EVR0/Inhaler-Counter-Project/2023 Team Final Report.docx

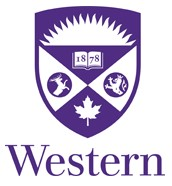
[picture p1: figure]
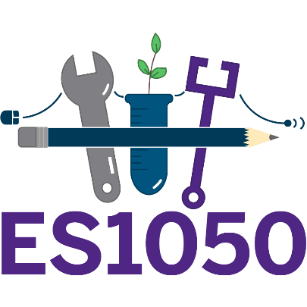
[picture p2: figure]

Western University Faculty of Engineering

Studio Section 027 – Jonathon Southen

Team Identifier: 27INHAL

Team Members: Richard Augustine, Anuda Dissanayake, Theo Graboski, Dylan Lo, Evan Romano, Ishan Randhawa

# Project Title: Non-Visual Inhaler Counter

Design Description: An electronically powered inhaler counter that utilizes audio feedback to communicate doses remaining in a canister to those who are visually impaired.

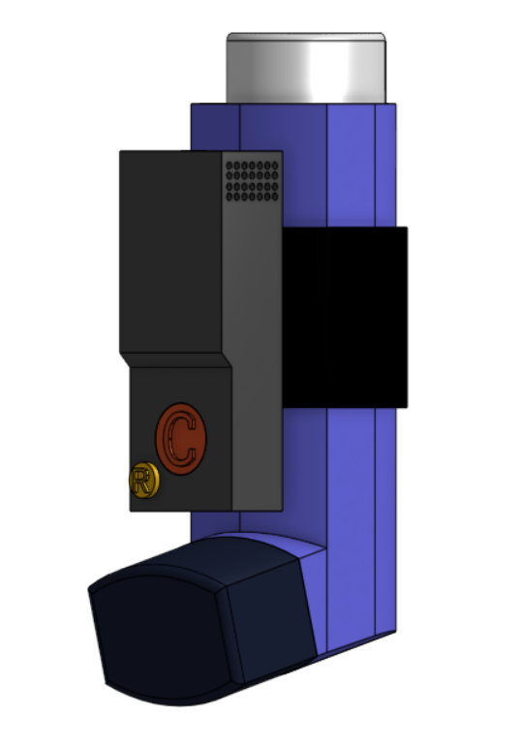
[picture p3: figure]

# 1 Need / Challenge

People with asthma and visual impairments need an easier method of monitoring the medicine consumption and availability of various inhaler types, because current methods of measurement are too visually oriented and lack tactile or auditory feedback.

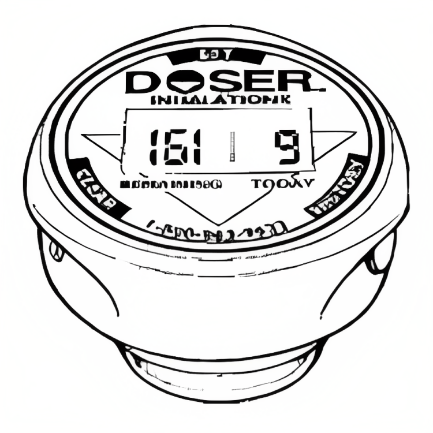
[picture p4: figure]
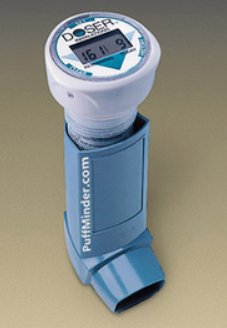
[picture p5: figure]

Existing inhaler counters in the market are solely visual-oriented, and there are none that use audio feedback to communicate remaining dosage. An example shown is the PuffMinder DOSER, which is an inhaler attachment that displays dosage using a segment display (PuffMinder). This highlights the need, from visually impaired communities, for a non-visual inhaler counter.

# 2 Final Design Documentation

REF: Figure 1: List of materials used to create the inhaler counter

Some additional tools used:

- Soldering iron
- 3D printer
- Hot glue gun
- Dremel tool

Design Overview:

Our design solution aimed to address the challenges faced by visually or audibly impaired individuals who struggle to keep track of the amount of medication left in their inhalers. Existing inhaler counters are unable to cater to the unique needs of individuals with visual or hearing impairments, making it extremely challenging for them to keep track of their medication intake.

To tackle this issue, we developed an innovative inhaler counter that incorporates both haptic and audible feedback mechanisms. The compact and easily accessible attachment comprises an Arduino circuit, a piezo buzzer, and a small 5V speaker, all of which are safely enclosed in a durable 3D-printed plastic case, connected to a small power bank, connected with a micro-USB port. The counter comes equipped with two large buttons, one to check the current dosage amount in the canister, and the other to count down the dosage. The buttons are purposely constructed larger to allow blind people to locate them easier.

Buttons:

The red button (distinguished for blind people with a little bump on top of it) serves as the counting button, and the counter will give a warning sound and buzz when the inhaler is low on puffs, indicated by counts below 20% on the counter. To reset the counter to the desired number of counts, the client simply holds down the red button for 2 seconds. The counter will automatically increase the number of doses by increments of 10 counts, making it versatile for different dosage-holding inhalers.

The yellow button is designed to read the current dosage of the inhaler. When pressed, the inhaler will play 3 jingles/buzzes if it is full or almost full-on dosage. As the inhaler reaches below 50% counts, the jingles will reduce to 2 jingles/buzzes. When the inhaler is low on counts (below 20%), the jingles will reduce to 1 jingle/buzz, signaling that the user should refill their medication. Both these buttons would sit flush with the case, modelled after how the buttons of car-keys sit flush with the case, to avoid accidental pressing of any of the buttons. The adjustable elastic band strap ensures that the inhaler counter is compatible with various types of inhalers, enabling clients to get an accurate estimate of their remaining medication. We decided against a Velcro-band due to the noise it creates when you detach and attach the band, which could potentially be irritating for the client.

3D-Printed inhaler Counter Case:

The case is constructed from a 3D printed PLA plastic, which is a cost and material effective solution to in-case the circuitry of the inhaler counter. This material is durable and lightweight to allow for easy portability. Holes were manually drilled in the front of the case to allow the speaker to be heard easier, similarly to how some children’s speaker toys have holes in the case to project the audio of the speaker. To ensure all the parts, stay in place inside the case, which used a Velcro band to essentially hold the circuit down to the base of the case.

REF: Figure 2: CAD model of the counter on an inhaler – front, side, and bird’s eye view.

3D Printed case CAD: https://cad.onshape.com/documents/8a499796033188533e099d55/w/adf7a8520d7a87b5bd451792/e/a437b7ff1ce1cee1345235dd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

CAD of the inhaler counter attached to the inhaler: https://cad.onshape.com/documents/7b21c56eded4eb05811d0dd9/w/42491a1a2af8003230763df1/e/c076f92898ddc23516b42c1d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

REF: Figure 3: Sketch/ diagram of the inhaler counter in multiple views and dimensions provided.

The electronic circuitry used in our inhaler counter consists of:

1. Buttons: To connect a button to an Arduino, connect one leg of the button to a digital input pin on the Arduino and the other leg to ground. We also added a pull-up/pull-down resistor to ensure a reliable input state.
2. Buzzer: To connect a buzzer to an Arduino, connect the positive leg of the buzzer to a digital output pin on the Arduino and the negative leg to ground. The use of the tone() function in the Arduino code is able to generate a specific frequency on the buzzer.
3. Speaker: To connect a speaker to an Arduino, we needed an amplifier circuit since the Arduino output pins can't drive a speaker directly. The amplifier chip we decided to build for this circuit is the LM386, which you can connect to the analog output pins of the Arduino. Then, we connected the speaker to the LM386 output pins.

All of which was connected on a protoboard instead of a breadboard which comes with several advantages:

A thin protoboard, also known as a low-profile protoboard, is a type of breadboard that is thinner than a standard breadboard. Thin protoboards are useful for a variety of reasons:

Space-saving: Thin protoboards take up less space than standard breadboards, which makes them ideal for small electronic projects where space is at a premium. Allow wires to connect above and below the protoboard which can save lots of extra space on the breadboard if wires are connected neatly.

Portable: Due to their compact size and light weight, thin protoboards are highly portable, making them ideal for use in the field or for mobile projects.

Easier to handle: Thin protoboards are easier to handle and manipulate than standard breadboards, which can be bulky and difficult to work with. This can be particularly useful when working with delicate or small electronic components.

Better signal integrity: Because thin protoboards have shorter and more direct connections between the components, they can provide better signal integrity, which is important for many electronic applications. This can be especially important when working with high-frequency or sensitive electronic circuits.

The main source of power which perform all the circuit functions was an Arduino Nano. The Arduino Nano is a compact and versatile microcontroller board which is very effective for a small device such as an inhaler counter, and provides many other notable characteristics:

- Small size: The Arduino Nano is very small and compact, which makes it easy to integrate into small electronic projects or embedded systems. It's also very light, which makes it ideal for mobile applications.
- Low cost: The Arduino Nano is relatively inexpensive compared to other microcontroller boards, which makes it an affordable option for a tight budget.
- Easy to use: The Arduino Nano is very easy to use, even for beginners. The board comes with built-in USB support, which means you can connect it to your computer and start programming right away.
- Versatility: The Arduino Nano is a very versatile microcontroller board, and it can be used for a wide range of applications. It has many input/output pins, which means you can connect a wide range of sensors, speakers, buzzers, etc.
- Compatibility: The Arduino Nano is fully compatible with the Arduino IDE, which means you can use the same programming environment and libraries that you're already familiar with.

REF: Figure 4: Visual layout of the circuitry used on the protoboard of our inhaler counter

Amplifier Component for the Speaker:

The LM386 is a low voltage audio power amplifier designed for use in low power applications. To connect it to a circuit, the first we connected the input to an audio source, which would be the Arduino nano. The next step is to connect the output to the 5V speaker. The LM386 requires a power source, which could either be a battery or a power supply, in our case it was a power bank. We utilized a voltage regulator to regulate the voltage supplied to the chip (transistor). A capacitor can be connected between the power supply and ground to filter out noise. We used a potentiometer to adjust the volume of the output. A resistor can be connected to the gain pin to adjust the gain of the amplifier.

To build a circuit with the LM386 chip, first we connected the input to a coupling capacitor / transistor and a potentiometer for volume control. Then connect the gain pin to a resistor and capacitor to set the gain of the amplifier. Connect the output pin to a coupling capacitor and then to a speaker or headphones. Finally, connect the power supply to the V+ and V- pins, with a capacitor between the V+ and ground to filter out noise. A bypass capacitor was also added between the V+ and V- pins to improve stability.

Figure 5: Circuit Diagram of the LM386

Audio Power amplifies with LM386: https://www.hobby-hour.com/electronics/lm386-power-audio.php

How to connect a lm386 Audio amplifier chip to a circuit: http://www.learningaboutelectronics.com/Articles/How-to-connect-a-LM386-audio-amplifier-chip

Purchase site for LM386: https://www.aliexpress.com/item/1005003424783772.html

Purchase site for potentiometer: https://www.amazon.ca/1k-100k-Single-Linear-Potentiometers-Resistor/dp/B07WQFS5WP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

Purchase site for the transistor: https://www.amazon.ca/Accessory-Elecfreaks-Transistor-Electronic-Component/dp/B085F32KHY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

Arduino Speaker Code:

This code is written in the Arduino programming language and is designed to control the dosage amount of the inhaler counter. The code uses an Arduino board with a yellow pushbutton, a red pushbutton, an LED, and a vibration motor. The yellow button is used to read information about the medication canister, while the red button is used to reset the canister count to zero. The LED is used to provide feedback on the state of the canister, and the vibration motor is used to provide an additional alert.

The code reads the state of each button and performs different actions based on the state of the yellow button. When the yellow button is pressed, the code checks the state of the canister (using a variable called `count` and determines how full the canister is. If the canister is more than halfway full, the LED is turned on, and the speaker plays three notes while the vibration motor buzzes three times. If the canister is more than a quarter full but less than or equal to halfway full, the speaker plays two notes while the vibration motor buzzes two times.

The code also implements a button debounce algorithm to avoid multiple readings of the same button press. When a switch is pressed, it can create multiple signal edges, which can cause the Arduino to register multiple counts for a single inhaler count. The debounce function helps to eliminate these false readings by delaying the response to the switch press until the signal has stabilized. This works in conjunction with the delay function, which is used in the scenario the user presses a button on the counter twice in quick succession, The delay function can be used to ensure that the device waits for enough time before detecting the next inhaler count.

Figure 6: Arduino IDE Code

A general flowchart that can be used to describe the path of possibilities that can be done when using the inhaler counter:

Figure 7: Inhaler Counter General Flowchart

# 3 Testing and Validation

## 3.1 Compliance Matrix: Constraints

# | Constraint | Compliance Assessment | Rationale/Evidence

1 | Budget must be under $60 | Met | The Arduino nano processor cost us $40. Between the speaker, buzzer, board, wiring, buttons, and elastic band, we came to a total of $55.78. For a full list of individual costs, refer to our production costs table, found in section 2 of this report.
2 | Prototype must be convenient and compact to avoid affecting the use of the inhaler itself. | Met | Our team produced an inhaler counter solution compact enough to still allow the user to fit the inhaler in their pocket. the inhaler counter does not affect the inhaler’s primary function in any way, since it is attached behind the inhaler. REF Figure 8: Final prototype with elastic band attachment left view
3 | Prototype can only use parts readily available from online markets. | Partially Met | Because the case was custom 3D printed, we cannot say that all the parts are readily available from online markets. However, 3D printing services are widely available if need be.
4 | Prototype must be able to last at least a day before needing to be recharged/battery replaced. | Not Met | We were not able to implement a rechargeable battery solution due to space; we would have had to have sacrificed our goal for a compact solution to implement a battery solution. We chose to accept an external power supply as the power solution for our prototype.
5 | Prototype must be durable to resist significant damage while in a bag for extended periods of time. | Partially Met | As for the prototype that we presented during the design showcase, the durability of the attachment was good but not outstanding, as it was a custom 3D printed plastic case. With a few modifications, we could make the case for the attachment out of a lightweight metal material, which would increase the durability considerably.
6 | The counter should be able to accurately track the number of puffs taken by the user. | Met | During the showcase, we showed through one demonstration after the other that the counter consistently communicates accurate dosage numbers. Between the work put into coding the Arduino and linking the counter buttons to the processor, we were able to successfully create a fully functional inhaler counter. Refer to the following file, which contains videos showcasing all of the functions of our inhaler counter: 27InhalDemos (https://uwoca-my.sharepoint.com/:f:/g/personal/raugust3_uwo_ca/EtmtHEQ5Kj1FlAfboX81ZZkB29dUGpwycKaMkQqLa1R1HQ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)
7 | The counter should provide clear and audible feedback, such as spoken instructions or beeps, so that the user can easily understand and operate the device. | Partially Met | We were successful in creating a counter with easy-to-hear & understand audio cues (beeps). However, spoken instructions could not be implemented due to the compatibility of the small speaker. An example of the attachment’s audio capabilities can be seen through this video: 27InhalTest_Reset (https://uwoca-my.sharepoint.com/:v:/g/personal/raugust3_uwo_ca/EfItwVvs5HJLo6Hxmwxh0K8BtAn0-sYC7dNO9yfbtbPE1w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)
8 | The inhaler counter should be compatible with a wide range of inhalers and medications so that it can be used by a broad population of people. | Met | Our elastic Velcro band allowed the attachment to be easily transferrable from one inhaler type to another. REF Figure 9: Final prototype with elastic band attachment right view
9 | The inhaler counter should be designed within the semester period. | Met | It was finished before the showcase and done well at that, considering we were honoured with the most popular project (crowd-voted).

## 3.2 Objectives Evaluation

# | Objective | Evaluation | Evidence

1 | Easy and intuitive usage: An inhaler for blind people should be designed in a way that it can be easily operated without the need for visual aids. | Exceeded | Our inhaler counter prototype emits audio signals and haptic vibrations that provide tactile feedback, enabling visually impaired users to operate the inhaler with ease. These features not only increase the accessibility of the device but also improve the user experience, ensuring that everyone can use it confidently and comfortably.
2 | Portability: Make the inhaler compact and portable, making it easy for the client to carry the inhaler with them. | Met | Our inhaler counter prototype has successfully met the portability requirement by being small, compact, and pocket-sized. It is easy for the client to carry the inhaler with them wherever they go. Additionally, the prototype features an adjustable strap that is flexible enough not to interfere with the client's everyday life. This strap allows the inhaler to be securely attached to the client's clothing or bag, ensuring that it is always within reach when needed.
3 | Audio cues: The inhaler should have audio cues to help the user identify when to inhale and when the dose has been delivered. | Not Met | our inhaler counter prototype does not currently include audio cues to indicate when to inhale or when the dose has been delivered. While the prototype has been designed with features to assist visually impaired users, it does not currently incorporate audio signals for this purpose.
4 | Durable design: The inhaler should be made from durable materials that can withstand daily use and accidental drops. | Exceeded | We have been able to design an inhaler counter prototype that is both durable and reliable. The inhaler counter has been constructed using high-quality plastic materials, which are specifically chosen for their durability and resistance to accidental drops or impacts. We understand that the device will be used frequently and needs to withstand daily wear and tear, which is why we have placed a strong emphasis on the durability of the materials used in its construction.
5 | Affordable: The inhaler should be affordably priced so that it is accessible to a wider range of blind people who need it. | Exceeded | We have been successful in creating an inhaler counter that is affordable and accessible to a wider range of blind people who need it. Our team has worked diligently to ensure that the cost of manufacturing the device is kept under budget, allowing us to price it under $60.
6 | Easy maintenance: the inhaler should be designed in a way that can be easily cleaned and maintained without the need for visual aid. | Exceeded | Our inhaler counter prototype has been designed to be easy to maintain, even without the need for visual aids. Its small and compact size makes it easy to handle and clean, while the simple design of the device means that it is not messy or complicated to maintain. The inhaler counter can be easily wiped down with a damp cloth, and any debris or residue can be removed from the device with a gentle brush or cloth.
7 | Accurate dosing: The inhaler should deliver accurate doses of medication to ensure effective treatment. | Met | Our inhaler counter prototype has been designed to deliver accurate doses of medication to ensure effective treatment for users. However, it is important to note that the inhaler must be manually pressed by hand to be used, and the inhaler and counter have to be pressed separately manually. While this may require a bit more effort on the part of the user, it also ensures that the device is delivering a precise and accurate dose each time it is used.
8 | Environmental impact: the inhaler should be designed to minimize waste and overall be environmentally friendly. | Met | our inhaler counter prototype has been designed with environmental sustainability in mind. Unlike many inhaler counters on the market today, our device is not a one-time use product, but rather a daily use device that can be used repeatedly over time. This reduces the amount of waste generated by the product and contributes to a more sustainable solution for managing respiratory health. To further minimize our environmental impact, we are also exploring the use of more environmentally friendly materials, such as recycled plastics, in the manufacturing process.

9

Battery life: The inhaler should be able to last long enough to last an entire day, to either be recharged or have the batteries swapped.

Not Met

Currently, our inhaler counter prototype relies on a separate power bank to operate, but we are aware that this is not the most convenient solution for users who need to carry the device with them throughout the day. Therefore, we are actively working on a more efficient power solution that will allow the inhaler counter to last an entire day without the need for external batteries. We are exploring the possibility of implementing a rechargeable battery into the device, which would eliminate the need for disposable batteries and provide a more sustainable solution. However, we do recognize that implementing a rechargeable battery may increase the size of the device slightly, and we are working to strike a balance between size and battery life to ensure the device remains portable and easy to use.
10 | Materials: The inhaler should be made of readily available materials that can be ordered off the internet. | Exceeded | We have designed our inhaler counter prototype to be made from readily available materials that can be easily sourced and ordered off the internet. In particular, the body of the inhaler counter is made from a type of plastic that can be purchased domestically from a variety of different suppliers. This not only ensures that the materials used in our device are easily accessible, but it also helps to keep the cost of production down, making the device more affordable and accessible to a wider range of users.

# 4 Comparisons

## 4.1 Comparison 1

# https://www.epill.com/doser.html

# REF Figure 10: PuffMinder DOSER - Inhaler Counter/ MDI Usage Monitor:

The PuffMinder DOSER is a useful and reasonably priced accessory that is simple to attach to the majority of inhalers. It has a sizable display screen that indicates how many doses have not yet been taken, as well as audio and visual alerts that indicate when it's time to take the next dose. The PuffMinder DOSER does not have a vibration motor, however, which is one of the features of our prototype. Also, it does not offer the opportunity to log how many dosages are taken each day or each week, which could be a disadvantage for some users who need more thorough medication monitoring. In conclusion, while the PuffMinder DOSER is a reliable and straightforward device, users who require additional features may find our prototype to be a better device.

## 4.2 Comparison 2

REF Figure 11: PUFFClicker Smart pMD inhaler Tracker
Site: Activ8rlives PUFFClicker Smart pMD Inhaler Tracker: (https://www.activ8rlives.com/puffclicker)

Using its smartphone app, the Activ8rlives PUFFClicker smart inhaler tracker provides customers with several features. It keeps track of how many dosages are taken each day, each week, and each month and notifies users when it is time to take their prescription. Nevertheless, the Activ8rlives PUFFClicker is far more expensive than competing products, such as our design, and requires a smartphone to access all its functions. Also, users who are blind may find it impractical due to its reliance on a smartphone connection. The Activ8rlives PUFFClicker, in conclusion, is a fantastic alternative for users who need precise medication monitoring and reminders, but it might not be feasible or affordable for all users.

## 4.3 Comparison 3

https://www.trudellmed.com/ca/en-CA/products/aerocount-dose-counter-tmai

## REF Figure 12: AEROCOUNT* Dose Counter (TMAI):

Most inhalers may be quickly and simply attached to the AEROCOUNT Dosage Counter thanks to its low cost and simplicity. A reset button allows the user to start over when they acquire a new inhaler, and it has a big display panel that shows how many doses are left to take. However, the AEROCOUNT Dosage Counter does not provide a way to keep track of how many doses are taken each day or each week, which can be problematic for some users. Also, some users may find it impractical to manually reset the device each time they obtain a new inhaler. As a result, while the AEROCOUNT Dosage Counter is a straightforward and reasonably priced gadget that can be a decent replacement for some users, individuals who need more capabilities or in-depth medication monitoring may find our prototype to be a better option.

# 5 Potential Improvements

Due to the time constraints and lack of experience in building with electronics, our prototype design has potential for many improvements. One improvement that could be pursued is to add voice readouts to the device. While we did consider this, the analog signals that came from using a voice library was not compactible with our digital speaker. To fix this, we would implement a digital-to-analog converter (DAC).

REF Figure 13: DAC Digital audio signal converter

A DAC, such as the DAC0800LCN (DAC0800LCN) shown, converts a digital audio signal into an analog audio signal to generate sound with more clarity. They are “usually used as a response to poor audio quality at the consumer level” (SoundGuys). They are small, inexpensive, easy to obtain and implement.

This way, the user can receive an exact dose count, rather than relying on sounds. It would also make it more intuitive for the user and those with less cognitive abilities to understand the functions of the attachment.

The addition of a rechargeable battery, such to what you may find in a smartphone, would be a very useful feature. This would allow the device to be used wirelessly instead of constantly being plugged in, making it more portable and convenient for the user.

REF Figure 14: Rechargeable Nickel-Metal-Hydride Battery

An example of a rechargeable battery that can be used is a Nickel-Metal-Hydride (NiMH) battery. NiMH batteries are small, easy to charge, and cost effective with a unit valued at $7.27 each (Solarbotics). However, NiMH batteries “have a slightly lower output voltage” (Digi-Key) which may not be able to power all the components as effectively as an alkaline battery.

There are other types of batteries, each with their own strengths and weaknesses, but to strike a balance between portability and functionality, it's crucial to consider the additional size and weight that a rechargeable battery would contribute to the device.

Finally, providing the customer with the ability to track their medicine doses over time is a beneficial feature we can provide, provided more time. For example, the device could store data on the number of doses taken since receiving the medication, which could be helpful for those who need to monitor their medication intake closely, such as doctors or pharmacists. To accomplish this, we would want to use more complex code, an example of which is shown below.

REF Figure 15: Medicine dose tracking code example

# 6 References

“PuffMinder DOSER - Inhaler Counter/ MDI Usage Monitor,” E-Pill. [Online]. Available: https://www.epill.com/doser.html. [Accessed: 06-Apr-2023].

“Do you need A DAC?,” SoundGuys, 30-Dec-2022. [Online]. Available: https://www.soundguys.com/do-you-need-a-dac-13488/. [Accessed: 06-Apr-2023].

“DAC0800LCN/NOPB: Digi-Key Electronics,” Digi-Key. [Online]. Available: https://www.digikey.ca/en/products/detail/texas-instruments/DAC0800LCN%2FNOPB/4652?productid=4652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. [Accessed: 06-Apr-2023].

“Which Rechargeable Battery is Best for your Arduino Project?,” Digi-Key, 29-Sep-2021. [Online]. Available: https://www.digikey.ca/en/maker/blogs/2021/which-rechargeable-battery-is-best-for-your-arduino-project. [Accessed: 06-Apr-2023].

“Lithium polymer battery - 110mah (LIPO),” Solarbotics Ltd., 24-Feb-2023. [Online]. Available: https://www.solarbotics.com/product/lithium-polymer-battery-110mah-lipo/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. [Accessed: 06-Apr-2023].

# 7 Appendix A – Examples of Design Documentation

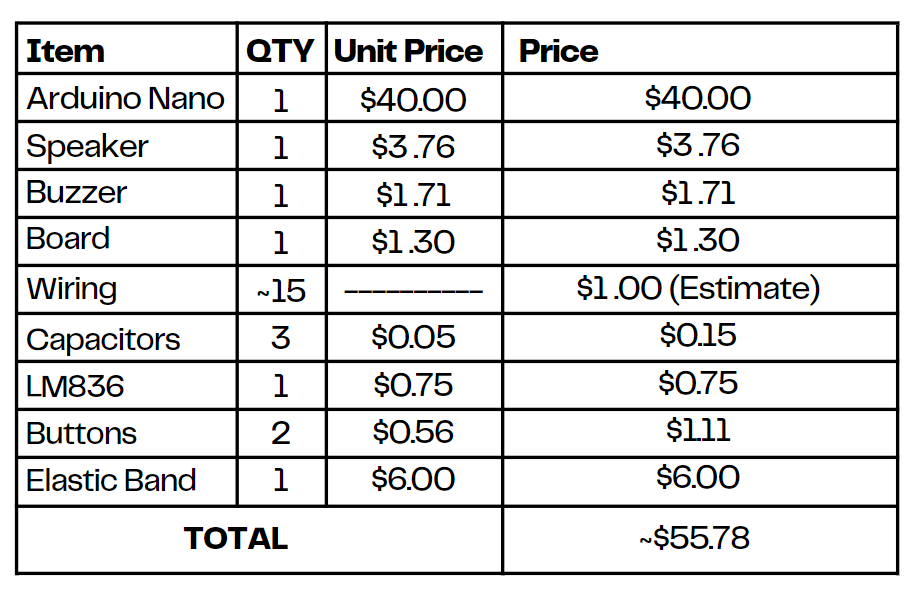
[picture p6: figure]
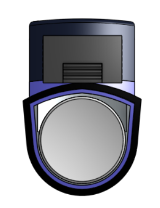
[picture p7: figure]
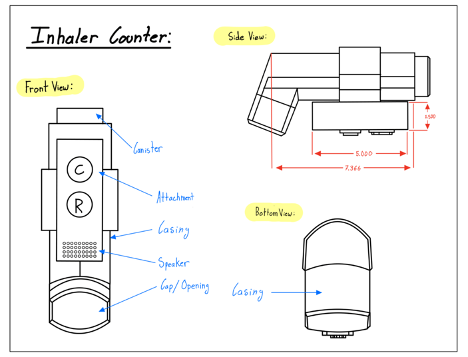
[picture p8: figure]
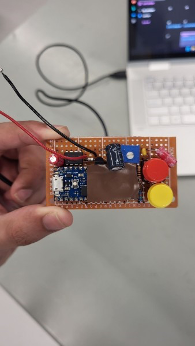
[picture p9: figure]
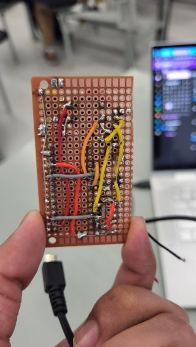
[picture p10: figure]
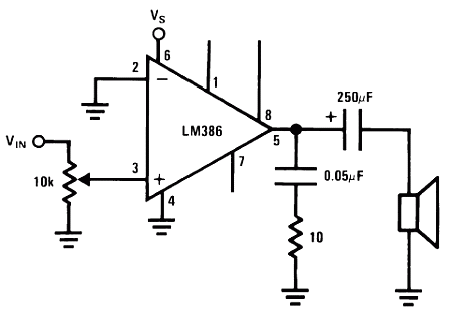
[picture p11: figure]
Audio Amplifier Gain = 20 with LM386
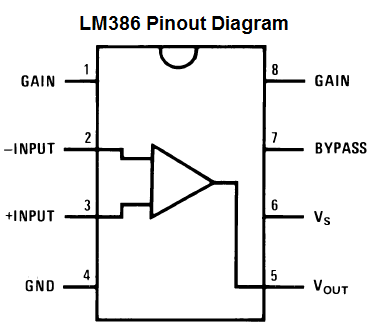
[picture p12: figure]
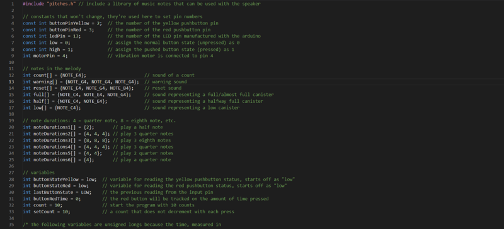
[picture p13: figure]
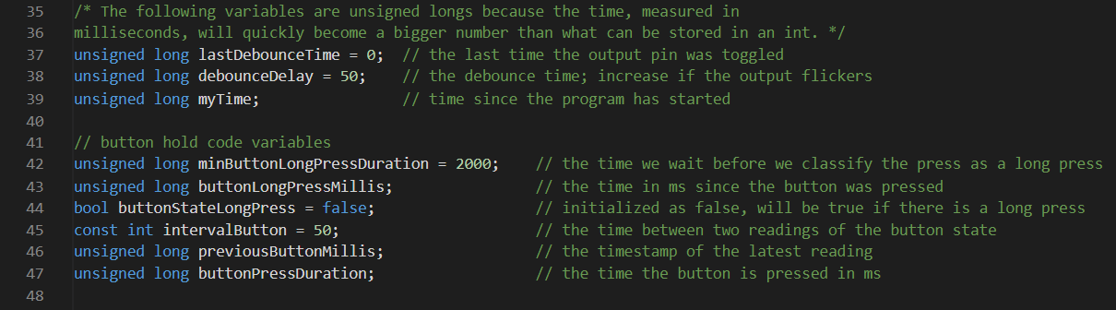
[picture p14: figure]
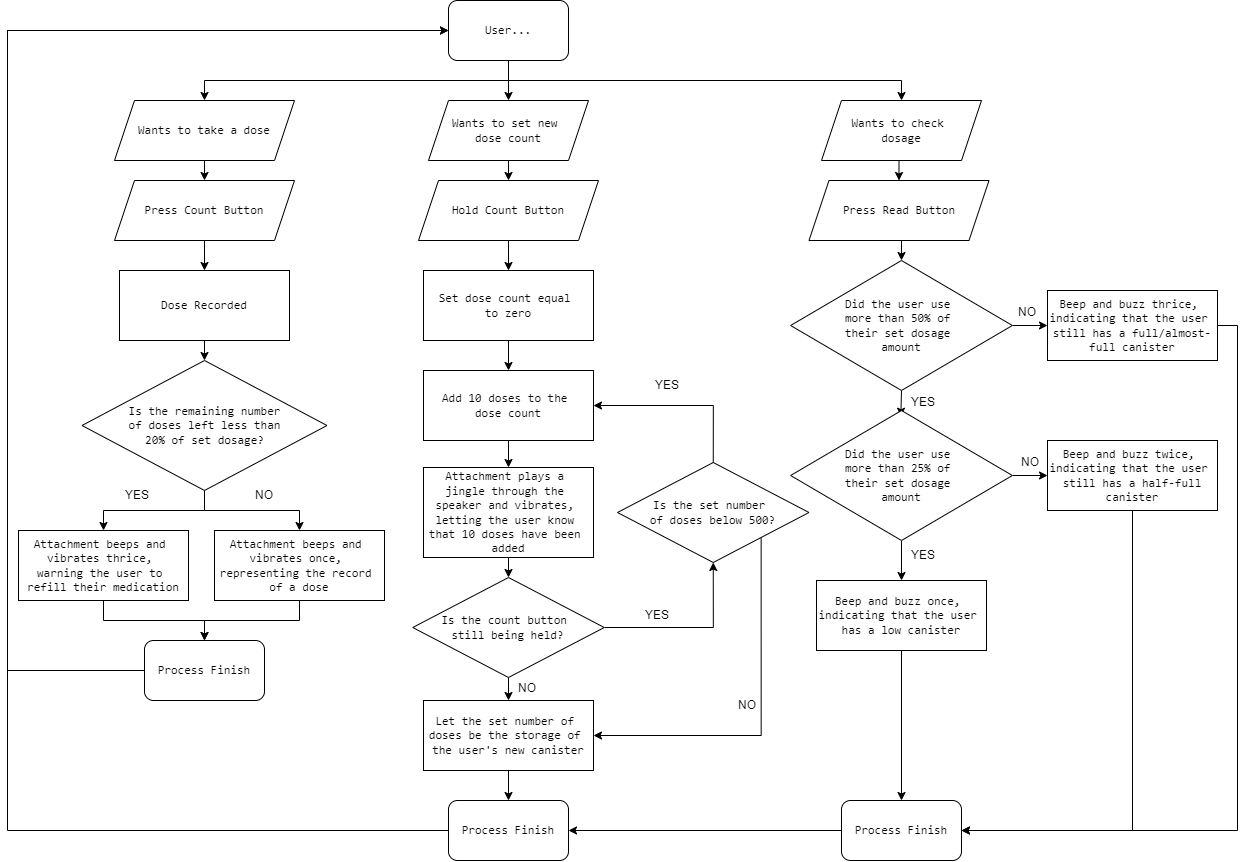
[picture p15: figure]
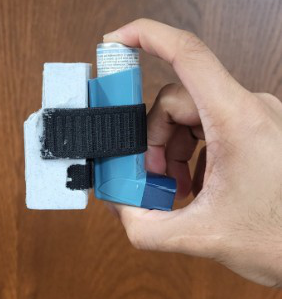
[picture p16: figure]
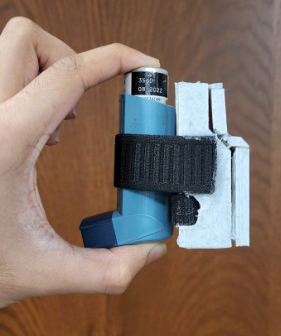
[picture p17: figure]
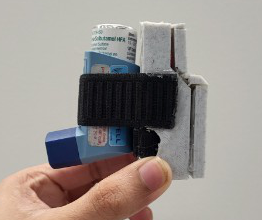
[picture p18: figure]
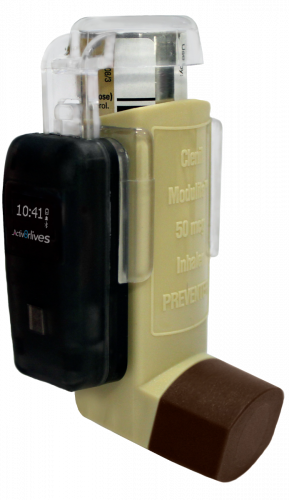
[picture p19: figure]
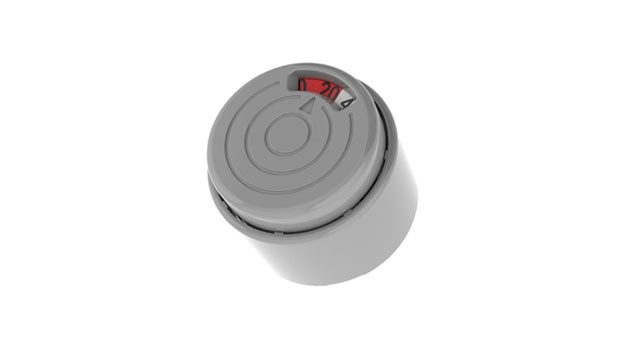
[picture p20: figure]
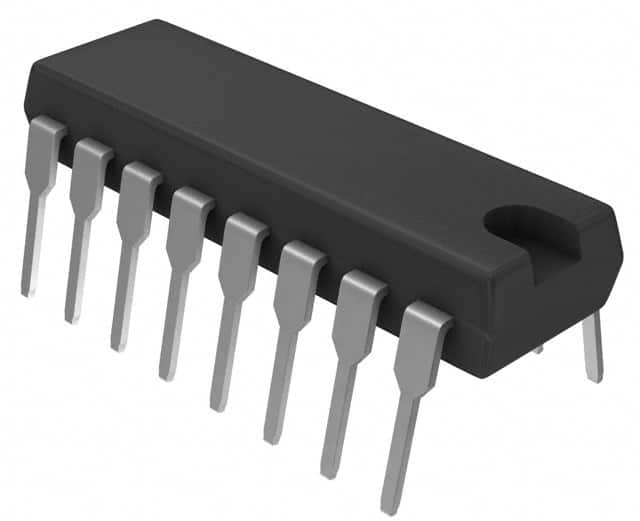
[picture p21: figure]
16-DIP SOT38-1
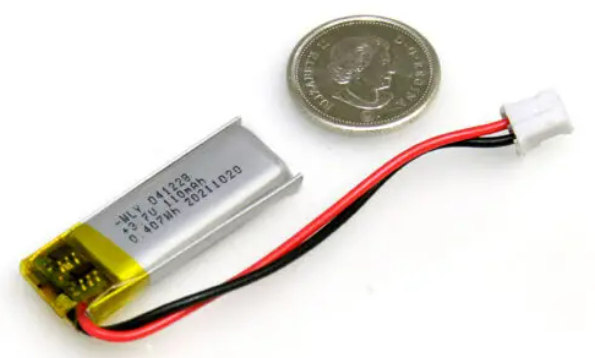
[picture p22: figure]
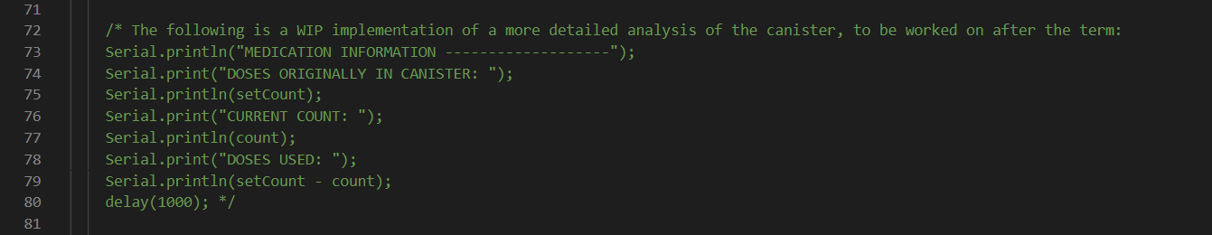
[picture p23: figure]

ES 1050 2023 Final Design and Assessment
