EVR0/Inhaler-Counter-Project/(list of files, cad)

Other CAD files:
Inhaler Counter Assembly.x_t
