EVR0/Inhaler-Counter-Project/(commit log)

2026-05-30 Add instructions to open ASSEMBLY file
2026-05-30 Add CAD model link to documentation
